VGCH/light_switch/images/IMG_20210913_153524_correct.jpg

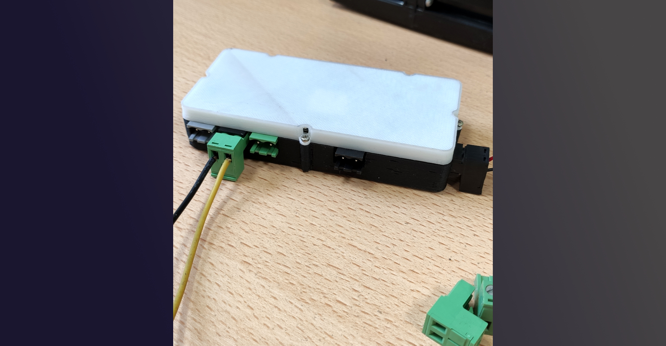
images/IMG_20210913_153524_correct.jpg
