VGCH/light_switch/images/IMG_20210912_160059_correct.jpg

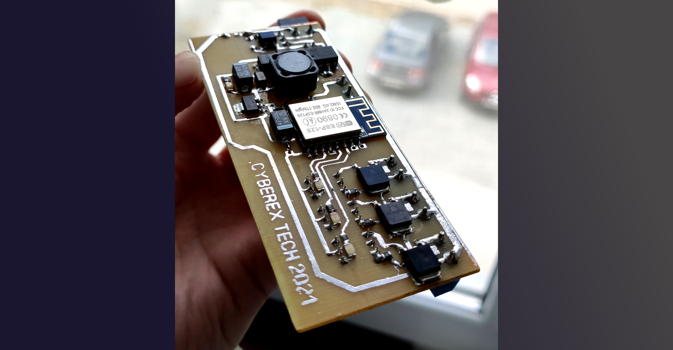
images/IMG_20210912_160059_correct.jpg
