VGCH/light_switch/images/IMG_20210912_111859_correct.jpg

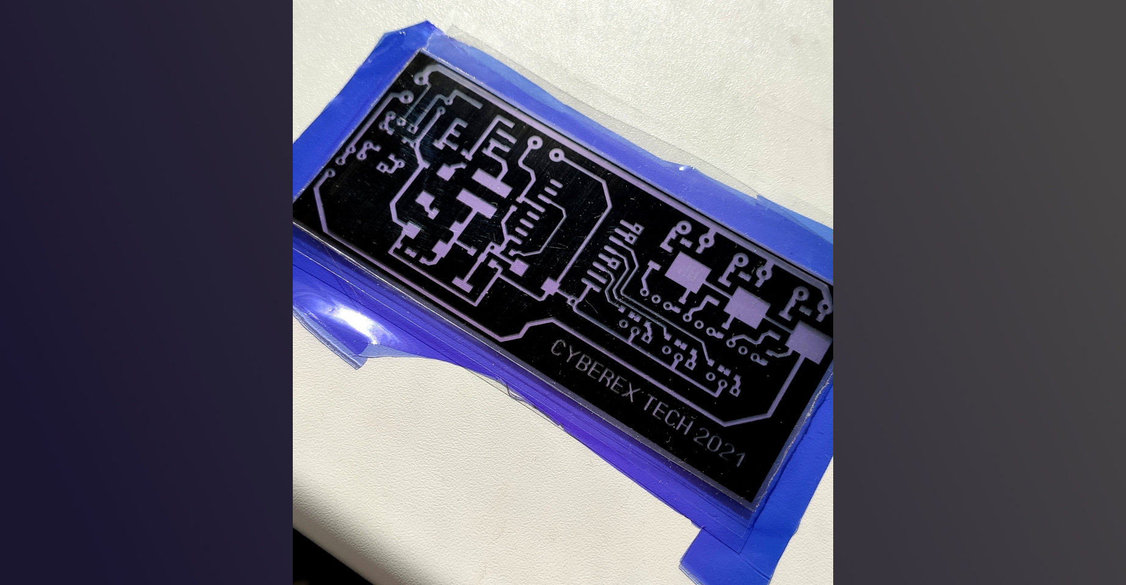
images/IMG_20210912_111859_correct.jpg
