VGCH/light_switch/images/IMG_20240731_182055_correct.jpg

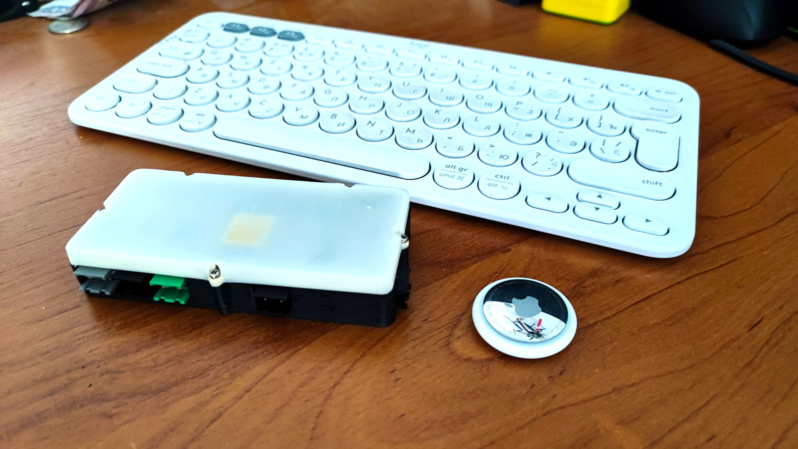
images/IMG_20240731_182055_correct.jpg
