VGCH/light_switch/images/light_switch_controller.png

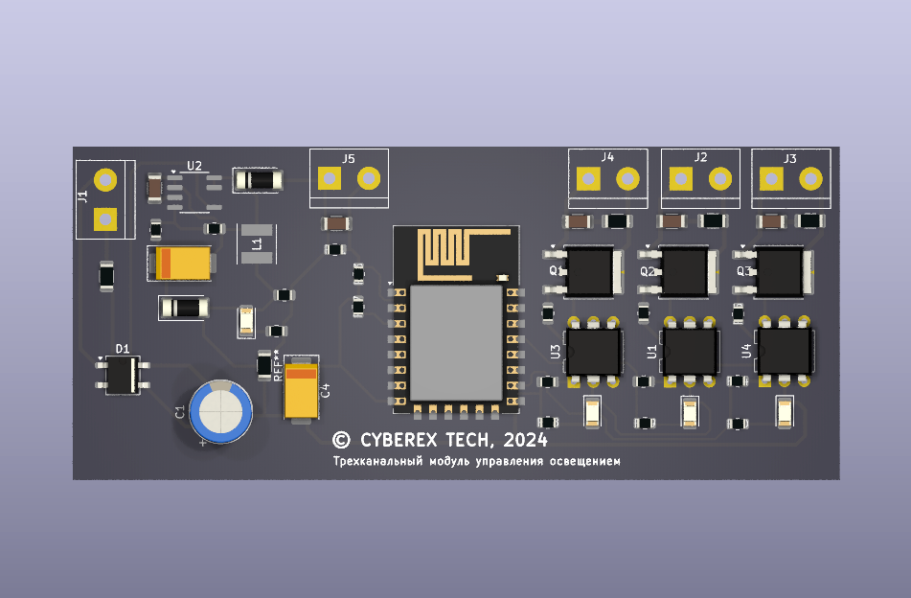
images/light_switch_controller.png
