VGCH/light_switch/images/sw_app.png

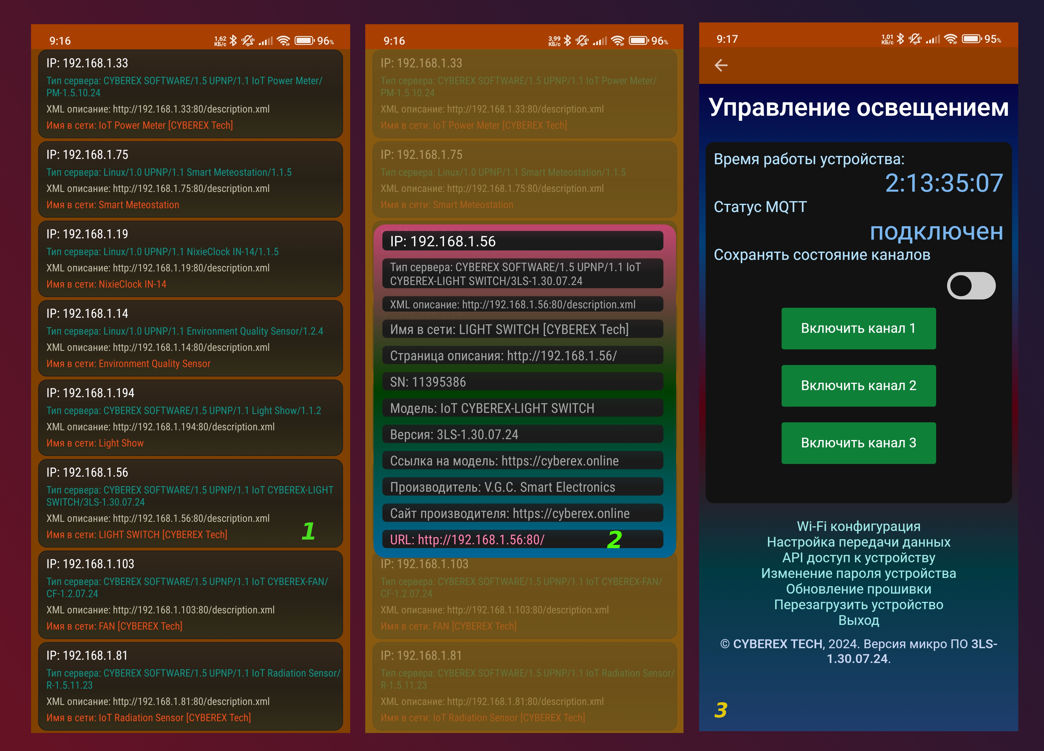
images/sw_app.png
