VGCH/light_switch/images/sw_circut.png

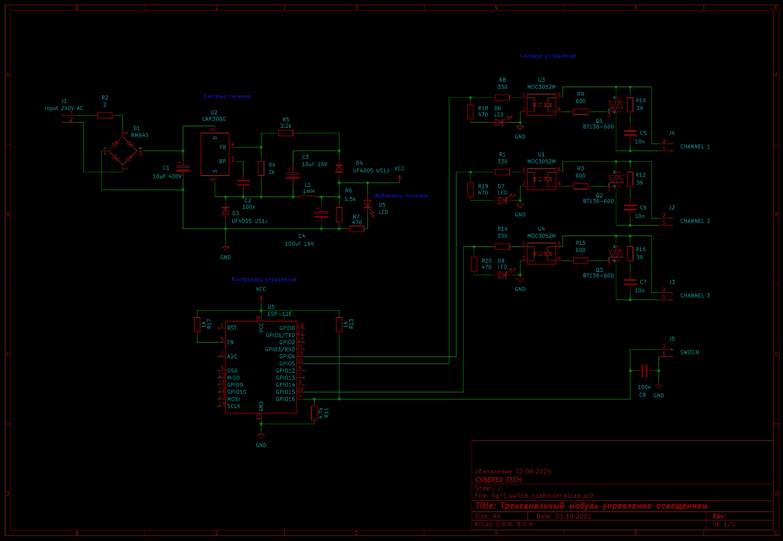
images/sw_circut.png
