VGCH/light_switch/images/Снимок экрана 2024-08-03 в 12.00.22.png

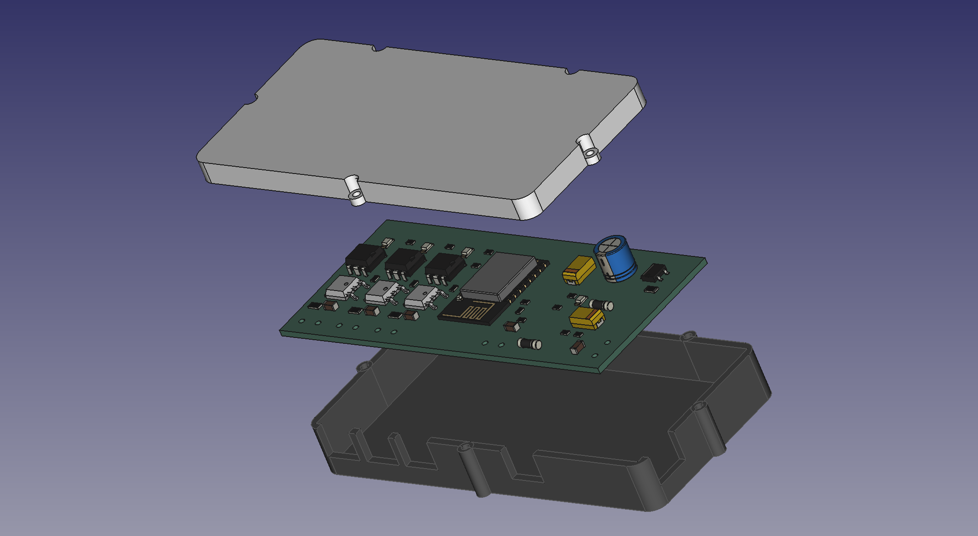
images/Снимок экрана 2024-08-03 в 12.00.22.png
