VGCH/light_switch/images/Снимок экрана 2024-08-03 в 12.01.37.png

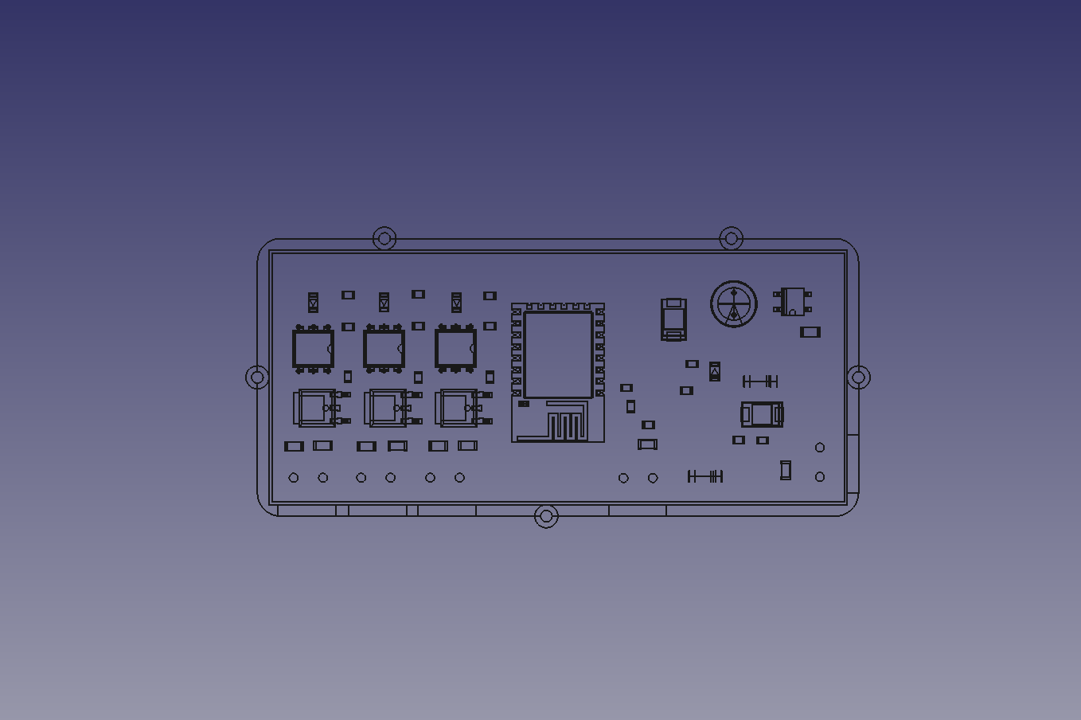
images/Снимок экрана 2024-08-03 в 12.01.37.png
