VGCH/light_switch/images/Снимок экрана от 2024-08-05 14-46-40.png

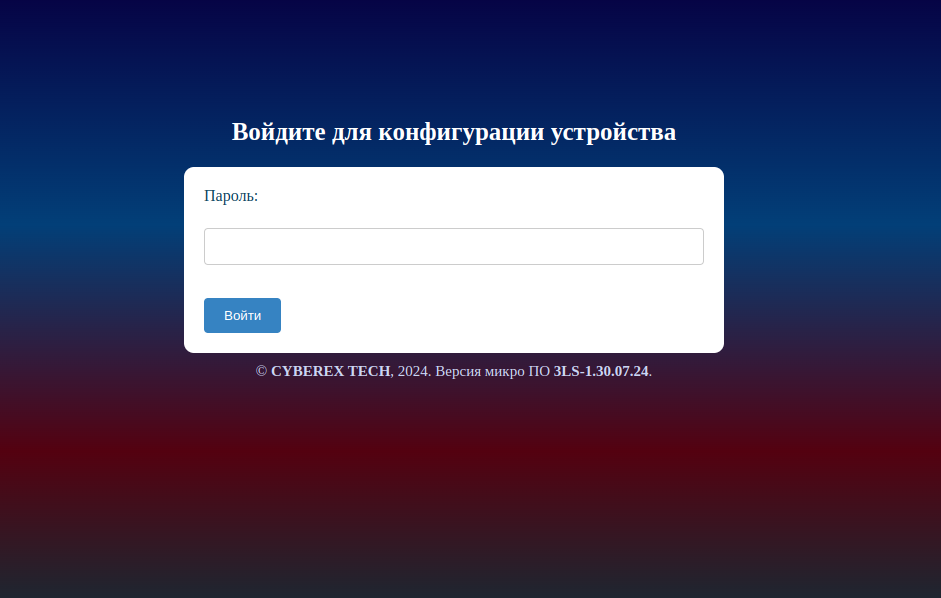
images/Снимок экрана от 2024-08-05 14-46-40.png
