VGCH/light_switch/images/Снимок экрана от 2024-08-05 14-47-06.png

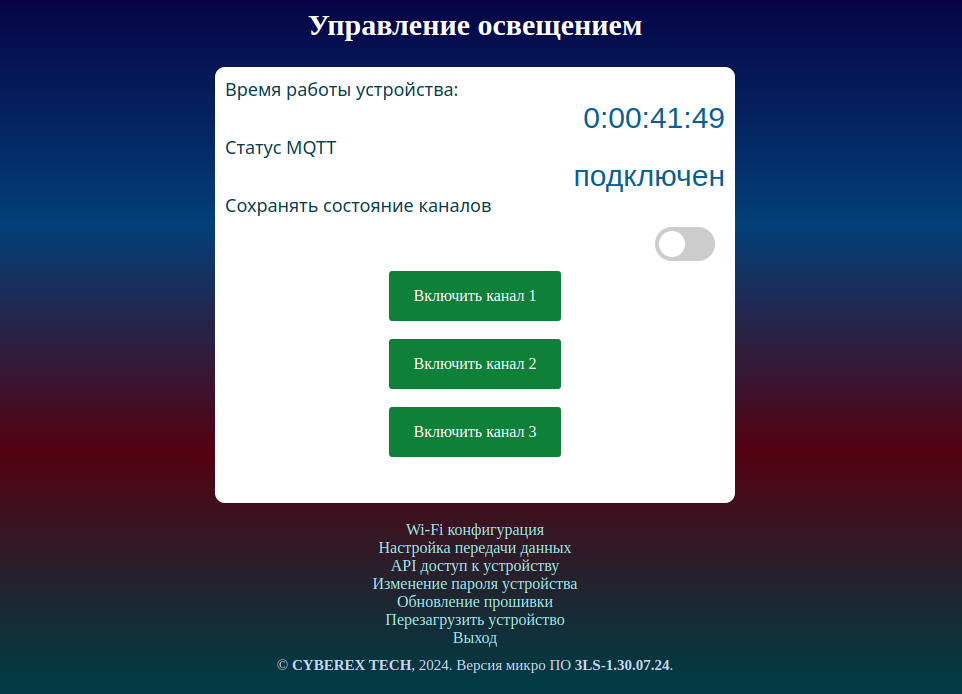
images/Снимок экрана от 2024-08-05 14-47-06.png
