VGCH/light_switch/images/Снимок экрана от 2024-08-05 14-47-38.png

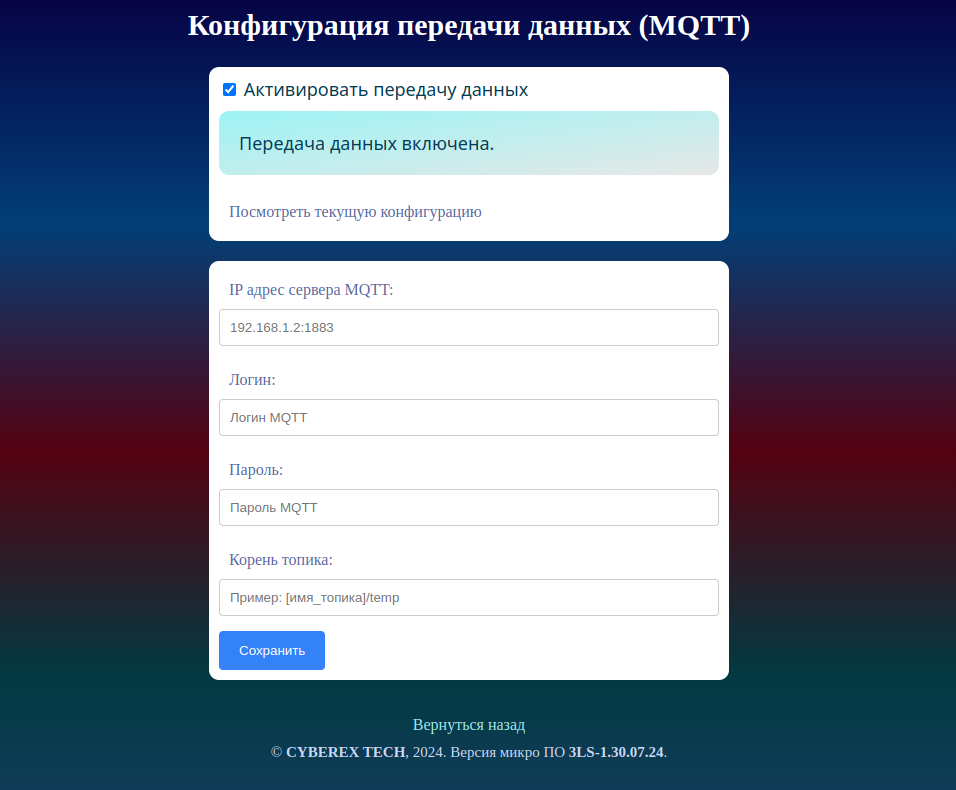
images/Снимок экрана от 2024-08-05 14-47-38.png
