VGCH/light_switch/images/Снимок экрана от 2024-08-05 14-48-00.png

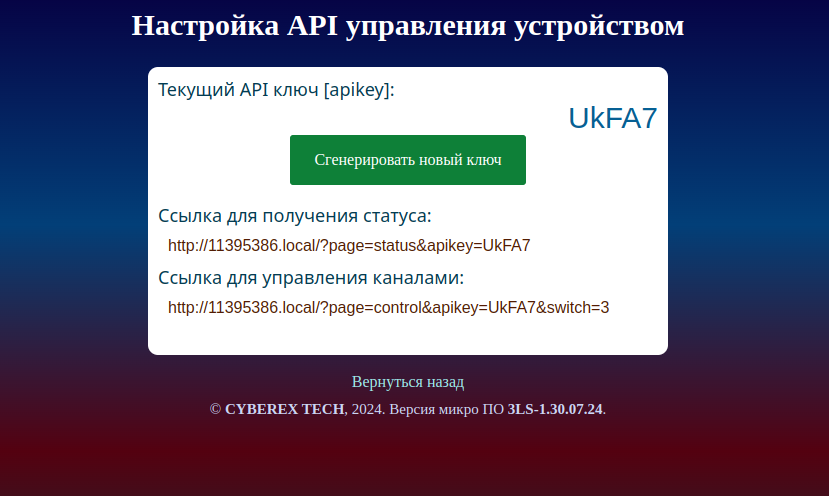
images/Снимок экрана от 2024-08-05 14-48-00.png
