VGCH/light_switch/board/light_switch_controller/light_switch_controller.step

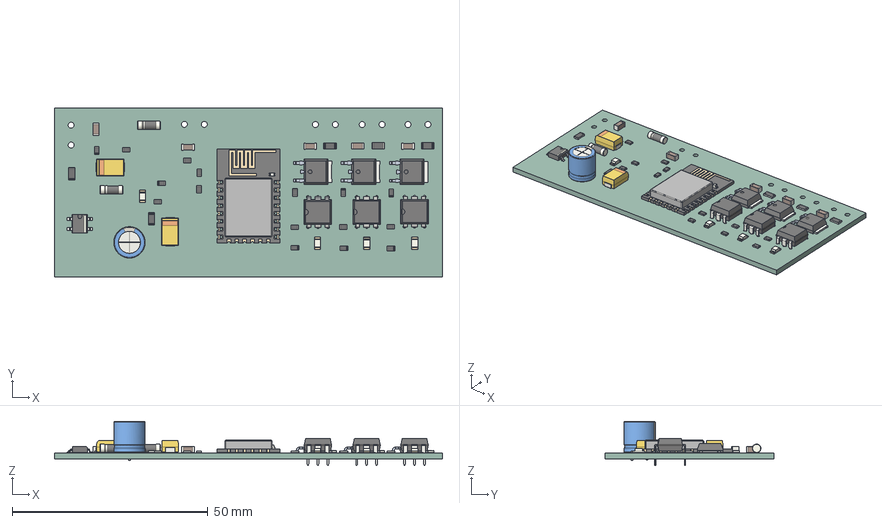
[picture p14: CAD file, 2024-08-06]
board/light_switch_controller/light_switch_controller.step
99.0 x 43.0 x 11.3 mm
TO-269AA
R_0805_2012Metric x 16
DIP-6_W7.62mm x 3
LED_1206_3216Metric x 4
C_1206_3216Metric x 5
CP_EIA_7343_31_Kemet_D x 2
CQ assembly x 3
R_1206_3216Metric x 5
D_MELF_Standard x 2
CP_Radial_D80mm_P380mm
ESP_12E001_cp
light_switch_controller_PCB
