VGCH/light_switch/light_switch_3CH/box.FCStd

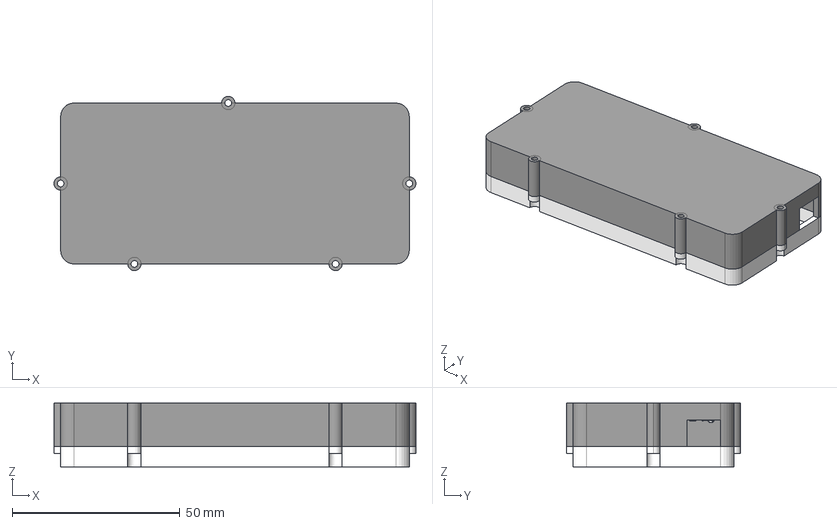
[picture p15: CAD file, 2024-08-06]
light_switch_3CH/box.FCStd
108.0 x 52.0 x 19.0 mm
TO-269AA002
R_0805_2012Metric032
DIP-6_W7.62mm006
R_0805_2012Metric034
R_0805_2012Metric036
R_0805_2012Metric038
R_0805_2012Metric040
LED_1206_3216Metric008
C_1206_3216Metric010
C_1206_3216Metric012
R_0805_2012Metric042
CP_EIA_7343_31_Kemet_D002
R_0805_2012Metric044
R_0805_2012Metric046
LED_1206_3216Metric010
C_1206_3216Metric014
CQ assembly003
R_1206_3216Metric008
C_1206_3216Metric016
R_1206_3216Metric010
R_0805_2012Metric048
R_0805_2012Metric050
D_MELF_Standard002
CQ assembly004
R_1206_3216Metric012
R_0805_2012Metric052
CP_EIA_7343_31_Kemet_D003
R_1206_3216Metric014
LED_1206_3216Metric012
R_1206_3216Metric016
CP_Radial_D80mm_P380mm001
CQ assembly005
R_0805_2012Metric054
R_0805_2012Metric056
DIP-6_W7.62mm008
C_1206_3216Metric018
DIP-6_W7.62mm010
R_0805_2012Metric058
D_MELF_Standard003
R_0805_2012Metric060
ESP_12E001_cp001
R_0805_2012Metric062
LED_1206_3216Metric014
light_switch_controller_PCB001
