VGCH/light_switch/light_switch_3CH/stl/top_box_l.stl

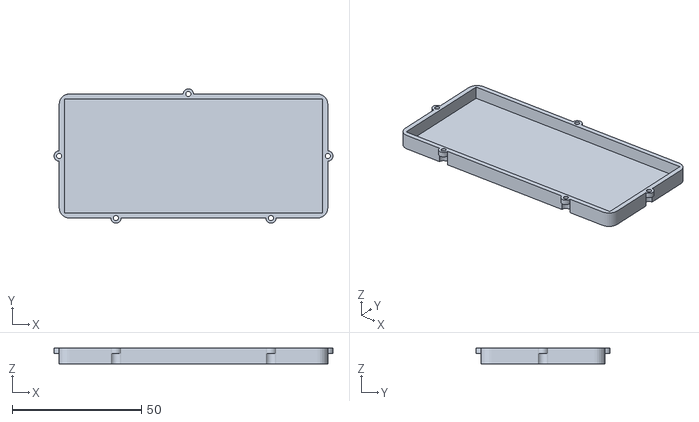
[picture p16: CAD file, 2024-08-06]
light_switch_3CH/stl/top_box_l.stl
108.0 x 52.0 x 6.00
