VGCH/light_switch/board/light_switch_controller/light_switch_controller.kicad_pcb

## KiCad design board/light_switch_controller/light_switch_controller.kicad_pcb (2024-08-06)

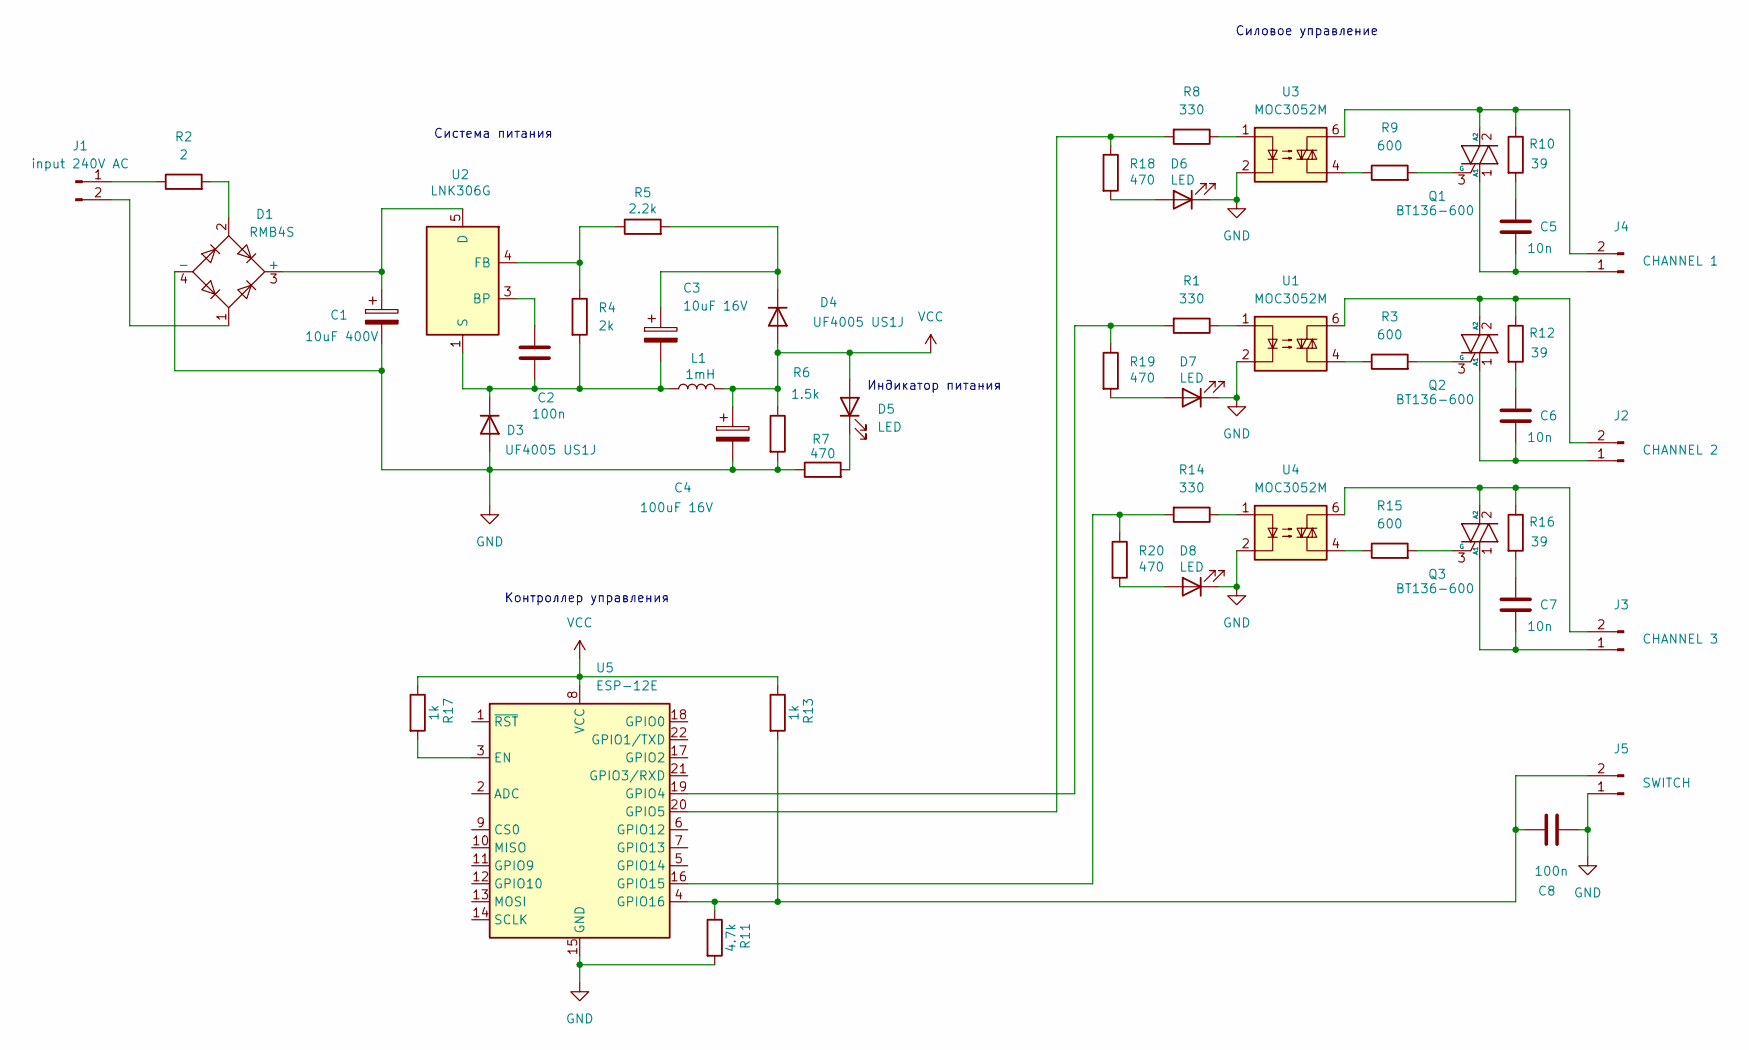
[picture p18: schematic light_switch_controller.kicad_sch, Трехканальный модуль управления освещением]

Parts:
C1: 10uF 400V; CP_Radial_D8.0mm_P3.80mm
C2, C8: 100n; C_1206_3216Metric
C3: 10uF 16V; CP_EIA-7343-31_Kemet-D_Pad2.25x2.55mm_HandSolder
C4: 100uF 16V; CP_EIA-7343-31_Kemet-D_Pad2.25x2.55mm_HandSolder
C5, C6, C7: 10n; C_1206_3216Metric
D1: RMB4S; TO-269AA
D3, D4: UF4005 US1J; D_MELF
D5, D6, D7, D8: LED; LED_1206_3216Metric
J1: input 240V AC; TerminalBlock_bornier-2_P5.08mm
J2: CHANNEL 2; TerminalBlock_bornier-2_P5.08mm
J3: CHANNEL 3; TerminalBlock_bornier-2_P5.08mm
J4: CHANNEL 1; TerminalBlock_bornier-2_P5.08mm
J5: SWITCH; TerminalBlock_bornier-2_P5.08mm
L1: 1mH; L_Taiyo-Yuden_NR-50xx
Q1, Q2, Q3: BT136-600; TO-252-2
R1, R8, R14: 330; R_0805_2012Metric
R2: 2; R_1206_3216Metric
R3, R9, R15: 600; R_0805_2012Metric
R4: 2k; R_0805_2012Metric
R5: 2.2k; R_0805_2012Metric
R6: 1.5k; R_0805_2012Metric
R7, R18, R19, R20: 470; R_0805_2012Metric
R10, R12, R16: 39; R_1206_3216Metric
R11: 4.7k; R_0805_2012Metric
R13, R17: 1k; R_0805_2012Metric
U1, U3, U4: MOC3052M; DIP-6_W7.62mm
U2: LNK306G; SOP-8_3.76x4.96mm_P1.27mm
U5: ESP-12E

Connections:
GND: C1.2, C4.2, C8.1, D1.4 (-), D3.2 (A), D6.1 (K), D7.1 (K), D8.1 (K), J5.1, R6.2, R7.1, R11.2, U1.2, U3.2, U4.2, U5.15 (GND)
unnamed: C5.1, R10.2
unnamed: C6.1, R12.2
unnamed: C7.1, R16.2
unnamed: C1.1, D1.3 (+), U2.5 (D)
unnamed: D1.2, R2.2
unnamed: C2.1, C3.2, D3.1 (K), L1.1, R4.2, U2.1 (S), U2.2 (S), U2.7 (S), U2.8 (S)
unnamed: C3.1, D4.1 (K), R5.2
unnamed: D5.1 (K), R7.2
unnamed: D6.2 (A), R18.2
unnamed: D7.2 (A), R19.2
unnamed: D8.2 (A), R20.2
unnamed: J1.1, R2.1
unnamed: D1.1, J1.2
unnamed: C6.2, J2.1, Q2.1 (A1)
unnamed: J2.2, Q2.2 (A2), R12.1, U1.6
unnamed: C7.2, J3.1, Q3.1 (A1)
unnamed: J3.2, Q3.2 (A2), R16.1, U4.6
unnamed: C5.2, J4.1, Q1.1 (A1)
unnamed: J4.2, Q1.2 (A2), R10.1, U3.6
unnamed: C8.2, J5.2, R11.1, R13.2, U5.4 (GPIO16)
unnamed: Q1.3 (G), R9.2
unnamed: Q2.3 (G), R3.2
unnamed: Q3.3 (G), R15.2
unnamed: R1.1, U1.1
unnamed: R3.1, U1.4
unnamed: R8.1, U3.1
unnamed: R9.1, U3.4
unnamed: R14.1, U4.1
unnamed: R15.1, U4.4
unnamed: C2.2, U2.3 (BP)
unnamed: R4.1, R5.1, U2.4 (FB)
unnamed: R17.2, U5.3 (EN)
unnamed: R1.2, R19.1, U5.19 (GPIO4)
unnamed: R8.2, R18.1, U5.20 (GPIO5)
unnamed: R14.2, R20.1, U5.16 (GPIO15)
VCC: C4.1, D4.2 (A), D5.2 (A), L1.2, R6.1, R13.1, R17.1, U5.8 (VCC)

Notes on the sheet:
Силовое управление
Система питания
Контроллер управления
Индикатор питания

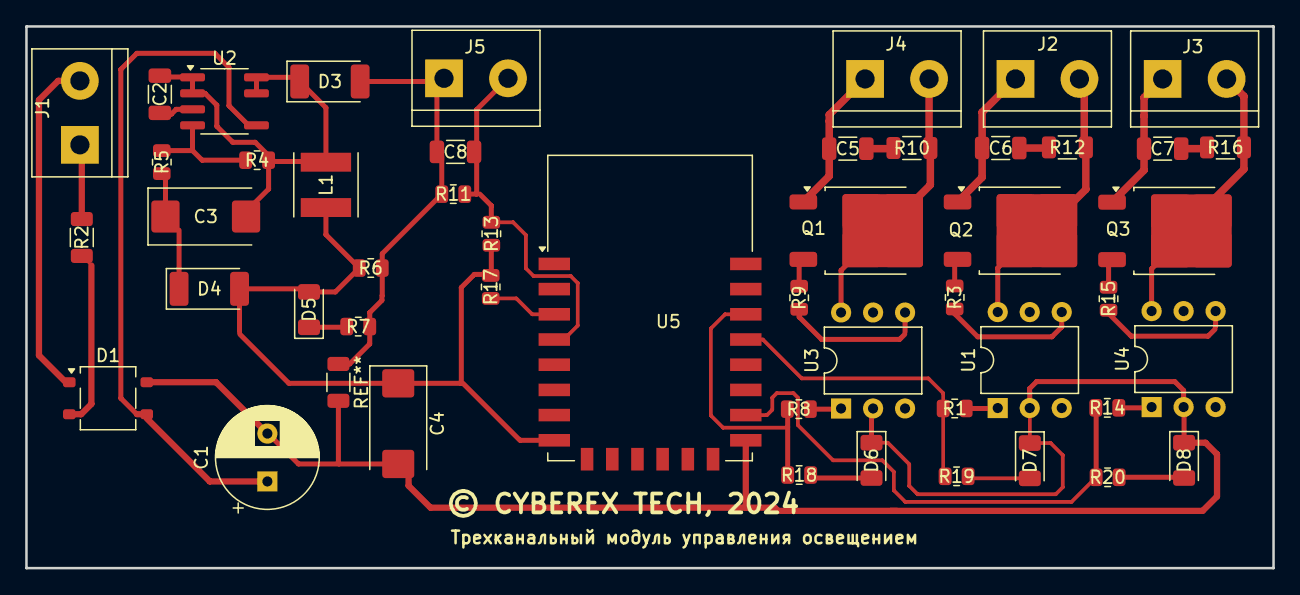
[picture p19: board light_switch_controller.kicad_pcb from above]

Board: 2 copper layers, 99.0 x 43.0 mm, 49 parts (0 on the bottom side), 37 nets.
