VGCH/light_switch/light_switch/light_switch.ino

/* Устройство для управления освещением
 *  © CYBEREX Tech, 2019 | UPDATE 2024
 * 
 */

#include <ESP8266WiFi.h>
#include <WiFiClient.h>
#include <ESP8266WebServer.h>
#include <ESP8266HTTPUpdateServer.h>
#include <DNSServer.h>
#include <ESP8266mDNS.h>
#include <EEPROM.h>
#include <ESP8266SSDP.h>
#include <PubSubClient.h>
#include <ArduinoJson.h>
#include "const_js.h"



#define channel1      5                  //канал 1
#define channel2      4                  //канал 2
#define channel3      15                 //канал 3
#define switch_hard   16                 //физический выключатель (Низкий уровень вкл)

// WEBs
ESP8266WebServer server(80);
WiFiClient espClient;
PubSubClient client(espClient);
IPAddress apIP(10, 10, 20, 1);
IPAddress netMsk(255, 255, 255, 0);
ESP8266HTTPUpdateServer httpUpdater;

// DNS server
const byte             DNS_PORT = 53;
DNSServer              dnsServer;

// Текущий статус WLAN
unsigned int status = WL_IDLE_STATUS;

// Переменные для хранения статуса сетевого подключения
boolean connect;
boolean wi_fi_st;

boolean stat_reboot, led_stat, stat_wifi, stat, annonce_mqtt_discovery, switch_h; 

// Переменные используемые для CaptivePortal
String ch_id_h = String(ESP.getChipId());
const char *myHostname  =  ch_id_h.c_str();            // Имя создаваемого хоста hostname.local 
const char *softAP_ssid = "CYBEREX-Light";             // Имя создаваемой точки доступа Wi-Fi

String version_code = "3LS-1.30.07.24";

//timers
uint32_t  prevMills, lastMsg, reboot_t, lastConnectTry;
int count_rf;
int sw_count;


// Структура для хранения токенов сессий 
struct Token {
    String value;
    long created;
    long lifetime;
};

Token   tokens[20];                    // Длина массива структур хранения токенов 

#define TOKEN_LIFETIME 6000000         // время жизни токена в секундах

#define MAX_STRING_LENGTH 30           // Максимальное количество символов для хранения в конфигурации


// Структура для хранения конфигурации устройства
struct {
     boolean mqtt_en;
     int     statteeprom; 
     char    mySSID[MAX_STRING_LENGTH];
     char    myPW[MAX_STRING_LENGTH];
     char    mqtt_serv[MAX_STRING_LENGTH];
     char    mqtt_user[MAX_STRING_LENGTH];
     char    mqtt_passw[MAX_STRING_LENGTH];
     char    mqtt_topic[MAX_STRING_LENGTH];
     char    passwd[MAX_STRING_LENGTH]; 
     char    API_key[MAX_STRING_LENGTH];
     boolean auto_on; 
     boolean _channel1;
     boolean _channel2; 
     boolean _channel3; 
  } settings;

  int set_delay = 5000;

void setup() {
    EEPROM.begin(sizeof(settings));                                 // Инициализация EEPROM в соответствии с размером структуры конфигурации      
    pinMode(channel1, OUTPUT);                                      // Светильник 1
    pinMode(channel2, OUTPUT);                                      // Светильник 2
    pinMode(channel3, OUTPUT);                                      // Светильник 3
    pinMode(switch_hard, INPUT);                                    // Аппаратный выключатель
    read_config();                                                  // Чтение конфигурации из EEPROM
    check_clean();                                                  // Провека на запуск устройства после первичной прошивки
     if(settings.auto_on){
        digitalWrite(channel1, settings._channel1);
        digitalWrite(channel2, settings._channel2);
        digitalWrite(channel3, settings._channel3);
     }
     if(String(settings.passwd) == ""){   
         //settings.passwd = "admin";                               // Если  переменная settings.passwd пуста, то назначаем пароль по умолчанию
         strncpy(settings.passwd, "admin", MAX_STRING_LENGTH);
     }
     
     WiFi.mode(WIFI_STA);                                           // Выбираем режим клиента для сетевого подключения по Wi-Fi                
     WiFi.hostname("Smart LIGHT CYBEREX TECH");                     // Указываеем имя хоста, который будет отображаться в Wi-Fi роутере, при подключении устройства
     if(WiFi.status() != WL_CONNECTED) {                            // Инициализируем подключение, если устройство ещё не подключено к сети
           WiFi.begin(settings.mySSID, settings.myPW);
      }

     for(int x = 0; x < 160; x ++){                                  // Цикл ожидания подключения к сети (80 сек)
          if (WiFi.status() == WL_CONNECTED){ 
                stat_wifi = true;
                break;
           }
               delay(500); 
      
          }

     if(WiFi.status() != WL_CONNECTED) {                             // Если подключение не удалось, то запускаем режим точки доступа Wi-Fi для конфигурации устройства
            WiFi.mode(WIFI_AP_STA);
            WiFi.softAPConfig(apIP, apIP, netMsk);
            WiFi.softAP(softAP_ssid);
            stat_wifi = false;
        }
        
        delay(2000);
        // Запускаем DNS сервер
        dnsServer.setErrorReplyCode(DNSReplyCode::NoError);
        dnsServer.start(DNS_PORT, "*", apIP);
        // WEB страницы
        server.on("/", page_process);
        server.on("/login", handleLogin);
        server.on("/script.js", reboot_devsend);
        server.on("/style.css", css);
        server.on("/index.html", HTTP_GET, [](){
        server.send(200, "text/plain", "IoT Radiation Sensor"); });
        server.on("/description.xml", HTTP_GET, [](){SSDP.schema(server.client());});
        server.on("/inline", []() {
        server.send(200, "text/plain", "this works without need of authentification");
        });
        server.onNotFound(handleNotFound);
        // Здесь список заголовков для записи
        const char * headerkeys[] = {"User-Agent", "Cookie"} ;
        size_t headerkeyssize = sizeof(headerkeys) / sizeof(char*);
        // Запускаем на сервере отслеживание заголовков 
        server.collectHeaders(headerkeys, headerkeyssize);
        server.begin();
        connect = strlen(settings.mySSID) > 0;                                            // Статус подключения к Wi-Fi сети, если есть имя сети
        SSDP_init();
          
}

void loop() {
        portals();
        dnsServer.processNextRequest();
        server.handleClient();  
        reboot_dev_delay();
        MQTT_send(); 
        hard_sw();
}

void reboot_devsend(){
   server.send(200, "text", reb_d);
}
